andrastantos/PicoROM/hardware/PicoROM.kicad_pcb

## KiCad design hardware/PicoROM.kicad_pcb (2024-12-27)

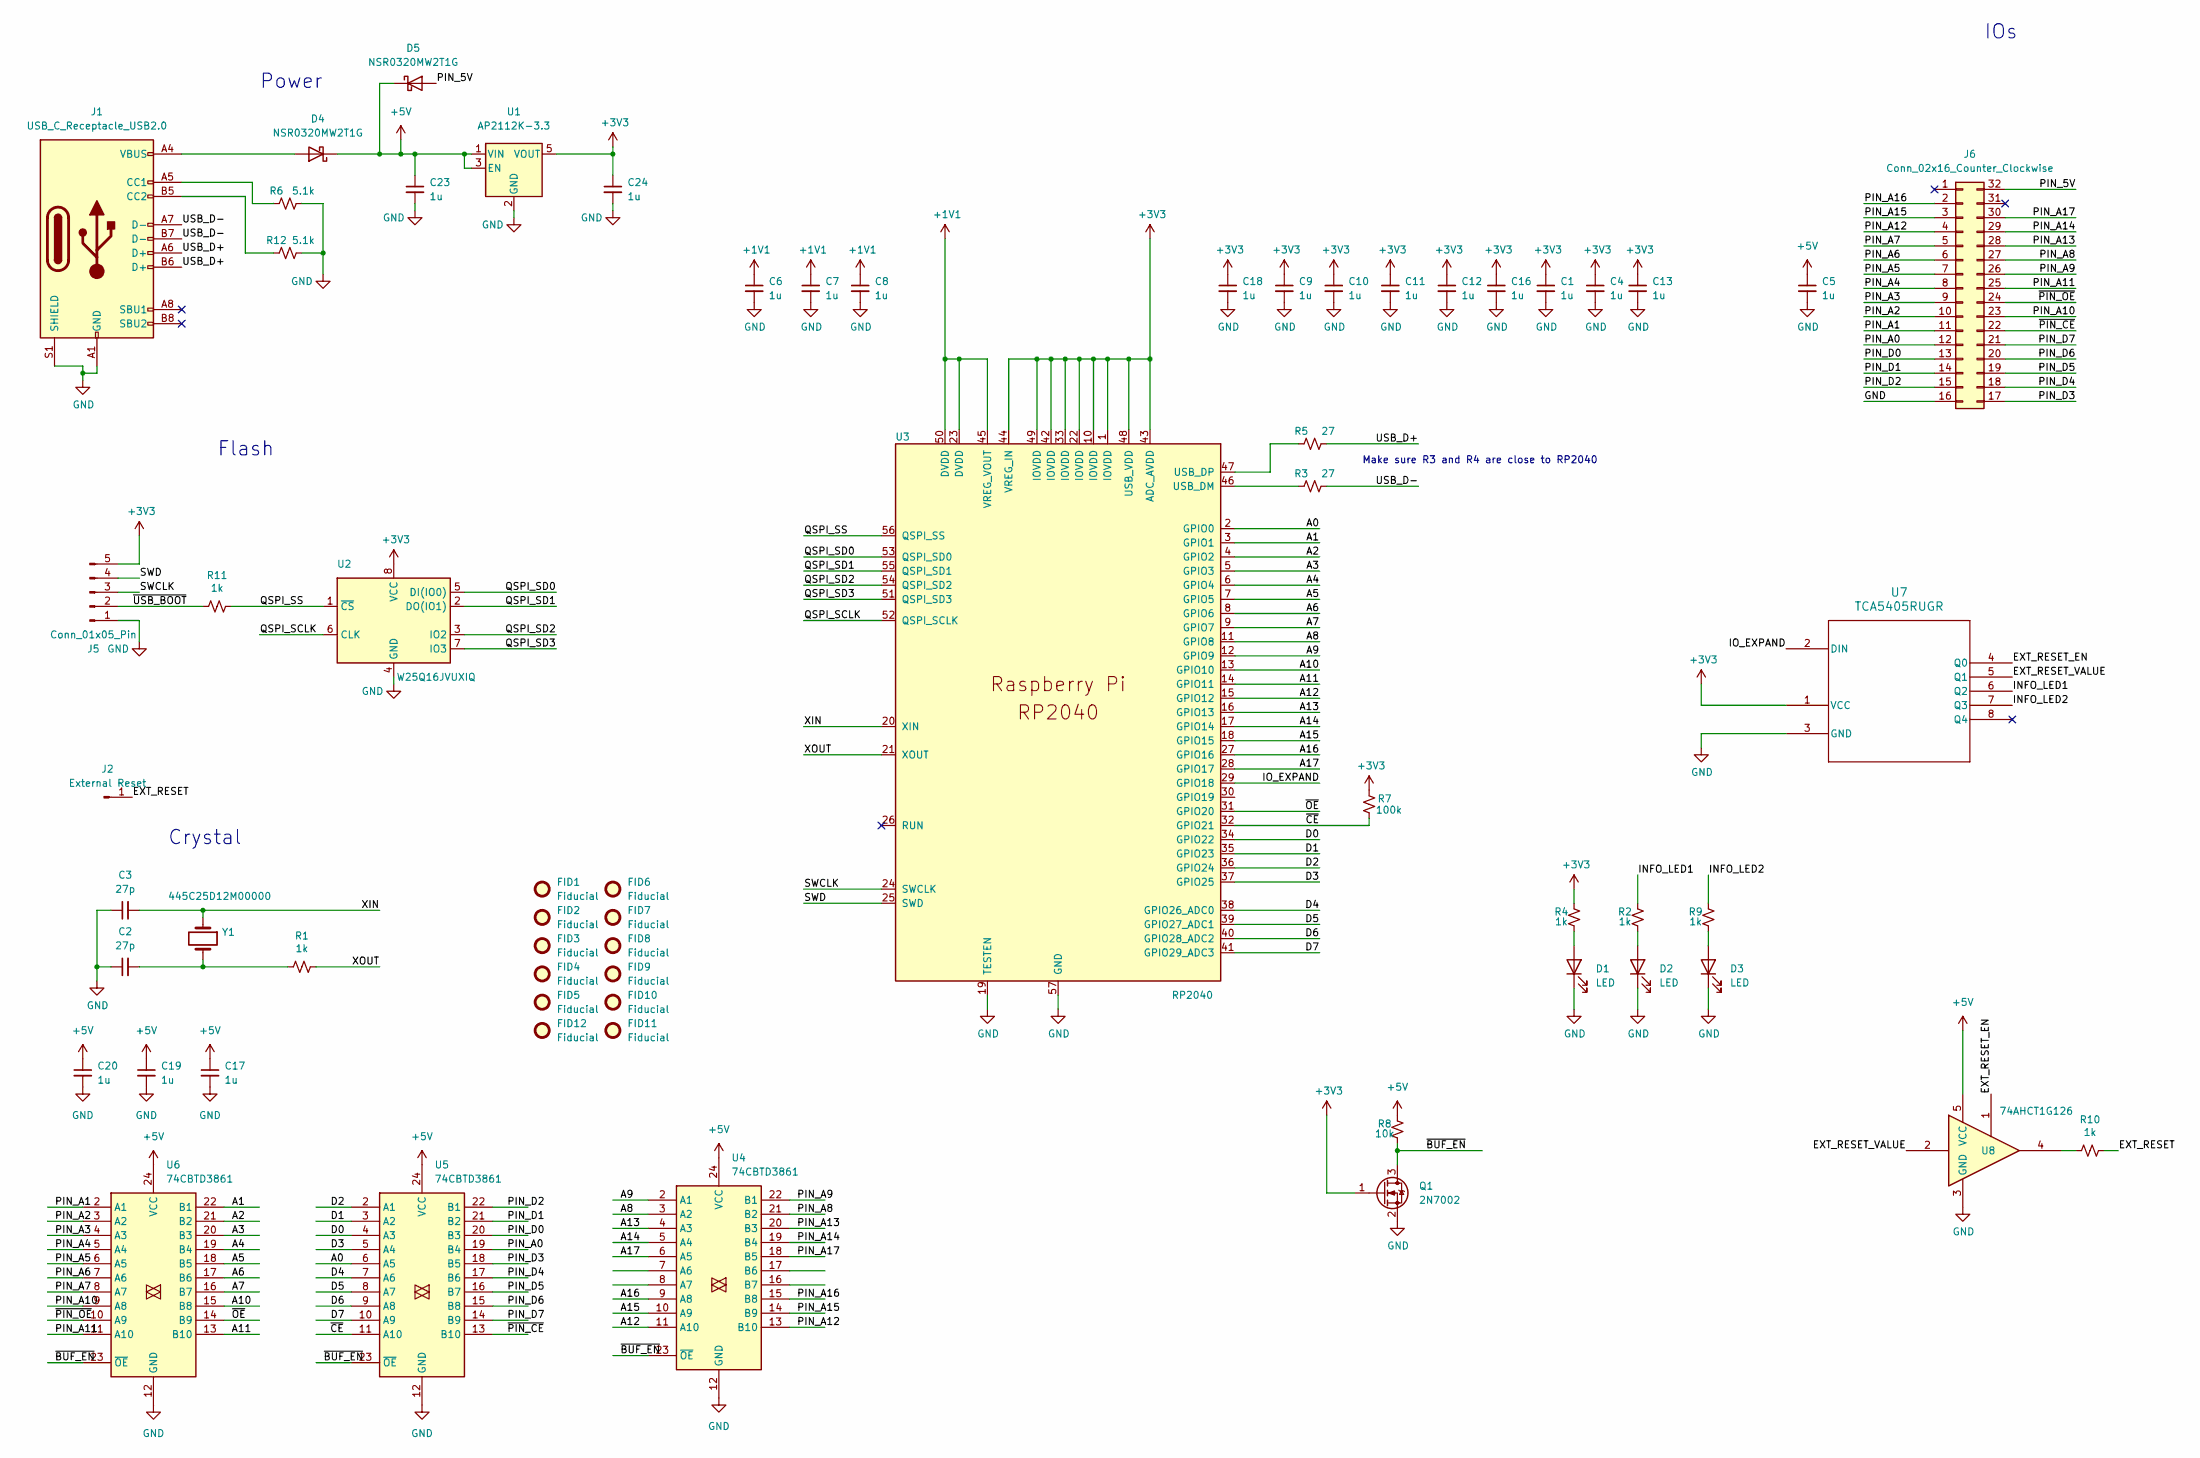
[picture p1: schematic PicoROM.kicad_sch, PicoROM - ROM Emulator]

Parts:
C1, C4, C5, C6, C7, C8, C9, C10, C11, C12, C13, C16, C17, C18, C19, C20, C23, C24: 1u; C_0402_1005Metric_Pad0.74x0.62mm_HandSolder
C2, C3: 27p; C_0402_1005Metric_Pad0.74x0.62mm_HandSolder
D1: LED; LED_0603_1608Metric; MPN C510027
D2: LED; LED_0603_1608Metric; MPN C2922668
D3: LED; LED_0603_1608Metric; MPN C2925173
D4, D5: NSR0320MW2T1G; D_SOD-323; MPN C48192
FID1, FID2, FID3, FID4, FID5, FID6, FID7, FID8, FID9, FID10, FID11, FID12: Fiducial; Fiducial_0.5mm_Mask1mm
J1: USB_C_Receptacle_USB2.0; USB_C_Receptacle_G-Switch_GT-USB-7051x; MPN C2843970
J2: External Reset; TestPoint_Pad_D3.0mm
J5: Conn_01x05_Pin; PinHeader_1x05_P1.00mm_Vertical
J6: Conn_02x16_Counter_Clockwise; DIP-32_pin_header
Q1: 2N7002; SOT-23
R1, R2, R4, R9, R10, R11: 1k; R_0402_1005Metric_Pad0.72x0.64mm_HandSolder
R3, R5: 27; R_0402_1005Metric_Pad0.72x0.64mm_HandSolder
R6, R12: 5.1k; R_0402_1005Metric_Pad0.72x0.64mm_HandSolder
R7: 100k; R_0402_1005Metric_Pad0.72x0.64mm_HandSolder
R8: 10k; R_0402_1005Metric_Pad0.72x0.64mm_HandSolder
U1: AP2112K-3.3; SOT-23-5; MPN C51118
U2: W25Q16JVUXIQ; Winbond_USON-8-1EP_3x2mm_P0.5mm_EP0.2x1.6mm; MPN C2843335
U3: RP2040; RP2040-QFN-56; MPN C2040
U4, U5, U6: 74CBTD3861; TSSOP-24_4.4x5mm_P0.4mm
U7: TCA5405RUGR; X2QFN-8_L1.5-W1.5-P0.50-BL; MPN C2674123
U8: 74AHCT1G126; SOT-23-5; MPN C163712
Y1: 445C25D12M00000; Crystal_SMD_5032-2Pin_5.0x3.2mm; MPN C148313

Connections:
+1V1: C6.1, C7.1, C8.1, U3.23 (DVDD), U3.45 (VREG_VOUT), U3.50 (DVDD)
+3V3: C1.1, C4.1, C9.1, C10.1, C11.1, C12.1, C13.1, C16.1, C18.1, C24.1, J5.5, Q1.1 (G), R4.2, R7.2, U1.5 (VOUT), U2.8 (VCC), U3.1 (IOVDD), U3.10 (IOVDD), U3.22 (IOVDD), U3.33 (IOVDD), U3.42 (IOVDD), U3.43 (ADC_AVDD), U3.44 (VREG_IN), U3.48 (USB_VDD), U3.49 (IOVDD), U7.1 (VCC)
+5V: C5.1, C17.1, C19.1, C20.1, C23.1, D4.1 (K), D5.1 (K), R8.2, U1.1 (VIN), U1.3 (EN), U4.24 (VCC), U5.24 (VCC), U6.24 (VCC), U8.5 (VCC)
/A0: U3.2 (GPIO0), U5.6 (A5)
/A1: U3.3 (GPIO1), U6.22 (B1)
/A2: U3.4 (GPIO2), U6.21 (B2)
/A3: U3.5 (GPIO3), U6.20 (B3)
/A4: U3.6 (GPIO4), U6.19 (B4)
/A5: U3.7 (GPIO5), U6.18 (B5)
/A6: U3.8 (GPIO6), U6.17 (B6)
/A7: U3.9 (GPIO7), U6.16 (B7)
/A8: U3.11 (GPIO8), U4.3 (A2)
/A9: U3.12 (GPIO9), U4.2 (A1)
/A10: U3.13 (GPIO10), U6.15 (B8)
/A11: U3.14 (GPIO11), U6.13 (B10)
/A12: U3.15 (GPIO12), U4.11 (A10)
/A13: U3.16 (GPIO13), U4.4 (A3)
/A14: U3.17 (GPIO14), U4.5 (A4)
/A15: U3.18 (GPIO15), U4.10 (A9)
/A16: U3.27 (GPIO16), U4.9 (A8)
/A17: U3.28 (GPIO17), U4.6 (A5)
/D0: U3.34 (GPIO22), U5.4 (A3)
/D1: U3.35 (GPIO23), U5.3 (A2)
/D2: U3.36 (GPIO24), U5.2 (A1)
/D3: U3.37 (GPIO25), U5.5 (A4)
/D4: U3.38 (GPIO26_ADC0), U5.7 (A6)
/D5: U3.39 (GPIO27_ADC1), U5.8 (A7)
/D6: U3.40 (GPIO28_ADC2), U5.9 (A8)
/D7: U3.41 (GPIO29_ADC3), U5.10 (A9)
/EXT_RESET: J2.1, R10.2
/EXT_RESET_EN: U7.4 (Q0), U8.1
/EXT_RESET_VALUE: U7.5 (Q1), U8.2
/INFO_LED1: R2.2, U7.6 (Q2)
/INFO_LED2: R9.2, U7.7 (Q3)
/IO_EXPAND: U3.29 (GPIO18), U7.2 (DIN)
/PIN_5V: D5.2 (A), J6.32
/PIN_A0: J6.12, U5.19 (B4)
/PIN_A1: J6.11, U6.2 (A1)
/PIN_A2: J6.10, U6.3 (A2)
/PIN_A3: J6.9, U6.4 (A3)
/PIN_A4: J6.8, U6.5 (A4)
/PIN_A5: J6.7, U6.6 (A5)
/PIN_A6: J6.6, U6.7 (A6)
/PIN_A7: J6.5, U6.8 (A7)
/PIN_A8: J6.27, U4.21 (B2)
/PIN_A9: J6.26, U4.22 (B1)
/PIN_A10: J6.23, U6.9 (A8)
/PIN_A11: J6.25, U6.11 (A10)
/PIN_A12: J6.4, U4.13 (B10)
/PIN_A13: J6.28, U4.20 (B3)
/PIN_A14: J6.29, U4.19 (B4)
/PIN_A15: J6.3, U4.14 (B9)
/PIN_A16: J6.2, U4.15 (B8)
/PIN_A17: J6.30, U4.18 (B5)
/PIN_D0: J6.13, U5.20 (B3)
/PIN_D1: J6.14, U5.21 (B2)
/PIN_D2: J6.15, U5.22 (B1)
/PIN_D3: J6.17, U5.18 (B5)
/PIN_D4: J6.18, U5.17 (B6)
/PIN_D5: J6.19, U5.16 (B7)
/PIN_D6: J6.20, U5.15 (B8)
/PIN_D7: J6.21, U5.14 (B9)
/QSPI_SCLK: U2.6 (CLK), U3.52 (QSPI_SCLK)
/QSPI_SD0: U2.5 (DI(IO0)), U3.53 (QSPI_SD0)
/QSPI_SD1: U2.2 (DO(IO1)), U3.55 (QSPI_SD1)
/QSPI_SD2: U2.3 (IO2), U3.54 (QSPI_SD2)
/QSPI_SD3: U2.7 (IO3), U3.51 (QSPI_SD3)
/QSPI_SS: R11.2, U2.1 (~CS), U3.56 (QSPI_SS)
/SWCLK: J5.3, U3.24 (SWCLK)
/SWD: J5.4, U3.25 (SWD)
/USB_D+: J1.A6 (D+), J1.B6 (D+), R5.2
/USB_D-: J1.A7 (D-), J1.B7 (D-), R3.2
/XIN: C3.2, U3.20 (XIN), Y1.1
/XOUT: R1.2, U3.21 (XOUT)
/~BUF_EN: Q1.3 (D), R8.1, U4.23 (~OE), U5.23 (~OE), U6.23 (~OE)
/~CE: R7.1, U3.32 (GPIO21), U5.11 (A10)
/~OE: U3.31 (GPIO20), U6.14 (B9)
/~PIN_CE: J6.22, U5.13 (B10)
/~PIN_OE: J6.24, U6.10 (A9)
/~USB_BOOT: J5.2, R11.1
GND: C1.2, C2.1, C3.1, C4.2, C5.2, C6.2, C7.2, C8.2, C9.2, C10.2, C11.2, C12.2, C13.2, C16.2, C17.2, C18.2, C19.2, C20.2, C23.2, C24.2, D1.1 (K), D2.1 (K), D3.1 (K), J1.A1 (GND), J1.A12 (GND), J1.B1 (GND), J1.B12 (GND), J1.S1 (SHIELD), J5.1, J6.16, Q1.2 (S), R6.2, R12.2, U1.2 (GND), U2.4 (GND), U3.19 (TESTEN), U3.57 (GND), U4.12 (GND), U5.12 (GND), U6.12 (GND), U7.3 (GND), U8.3 (GND)
unnamed: C2.2, R1.1, Y1.2
unnamed: D1.2 (A), R4.1
unnamed: D2.2 (A), R2.1
unnamed: D3.2 (A), R9.1
unnamed: D4.2 (A), J1.A4 (VBUS), J1.A9 (VBUS), J1.B4 (VBUS), J1.B9 (VBUS)
unnamed: J1.A5 (CC1), R6.1
unnamed: J1.B5 (CC2), R12.1
unnamed: R10.1, U8.4
unnamed: R3.1, U3.46 (USB_DM)
unnamed: R5.1, U3.47 (USB_DP)

Notes on the sheet:
Flash
Power
Make sure R3 and R4 are close to RP2040
Crystal
IOs

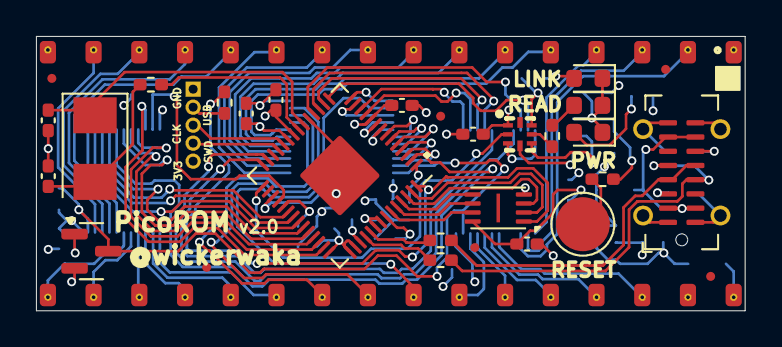
[picture p2: board PicoROM.kicad_pcb from above]

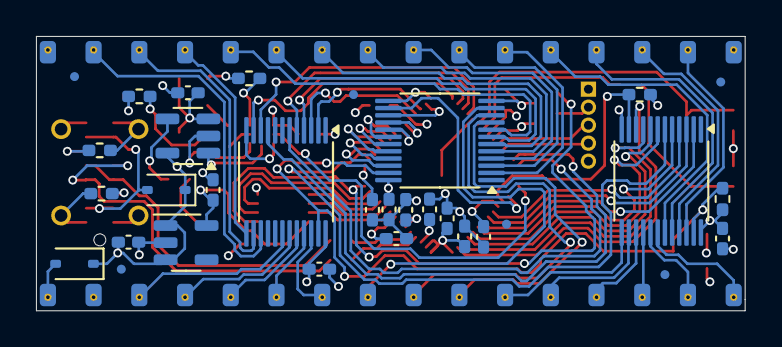
[picture p3: board PicoROM.kicad_pcb from below]

Board: 4 copper layers, 39.4 x 15.2 mm, 63 parts (32 on the bottom side), 91 nets.
